leonardoAB1/mobile_robot_esp32/automation/lab_01/results/informe.pdf

# Implementation of a Low-Level Digital Controller for DC Motors

Laboratory 1

Leonardo Acha Boiano ´
Mechatronics Engineering: IMT 342 Universidad Catolica Boliviana ´ Santa Cruz de la Sierra, Bolivia leonardo.acha@ucb.edu.bo

Abstract

This report presents the implementation of a low-level digital controller for DC motors in the context of a mechatronics engineering laboratory. The work addresses from the measurement of the input signal to the implementation and evaluation of the digital controller. The process of measuring the input signal, monitoring pulse-width modulation (PWM), and implementing open-loop control of the DC motor is described. In the second part of the laboratory, an open-loop system for the plant is developed, a PID controller in parallel configuration is designed and tuned, and the parameters are transferred to the real plant. The experimental results show the performance of the closed-loop system against different types of inputs, such as sinusoidal signals and steps. This work provides a comprehensive overview of the implementation of digital controllers for DC motors in mechatronic applications.

Index Terms

Control, Motor, ESP32, PID, Matlab, Open Loop, Closed Loop, Encoder.

I. INTRODUCTION
This report presents the implementation of a low-level digital controller for DC motors in the context of a mechatronics engineering laboratory. This work focused on understanding and applying key concepts of control, pulse-width modulation (PWM), and closed-loop systems to optimize the performance and accuracy of the DC motor. Throughout the report, the stages of the experimental process are described, from the measurement of the input signal to the implementation and evaluation of the digital controller, providing a detailed view of this important area of mechatronics engineering.

II. PROCEDURE
The methodology used in the laboratory was developed as follows. First, the input signal was measured via the wifi connection implemented in the microcontroller, in this case, the STM32. The input signal was sinusoidal and came from a program simulating an analog signal generator, sending the digitized signal with a 16-bit resolution.
Subsequently, the correct operation of the pulse-width modulation (PWM) module was monitored using an oscilloscope to ensure that the PWM generated the signal correctly with varied frequencies.
Then, the pulse control of the DC motor was implemented, which involved calculating the PWM duty cycle based on the input signal as shown in Figure 1. Additionally, the direction of motor rotation was determined in relation to the ADC range, and the sign of the signal was provided separately.
The next step involved controlling the speed and direction of the motor, which was achieved by adjusting the PWM duty cycle.
To obtain the open-loop system’s Bode Plot of phase and amplitude, the system’s response to a step input was recorded, from which the system parameters were extracted.
In the second part of the laboratory, focused on building the closed-loop system, a digital controller was synthesized and implemented on the platform using the model previously obtained in the open-loop system to tune the controller in simulation. This controller was designed to meet technical specifications, including an overshoot of less than 30% and a system error of e = 2° for a signal at 0.05 Hz.
Finally, the quality of the closed-loop system was evaluated to ensure it met the established technical requirements.

III. RESULTS

A. Plant Development


Figure 1. Encoder Signal of the Motor Visualized on the Oscilloscope

Figure 1 shows the encoder signal of the DC motor, captured and visualized on an oscilloscope. This graphical representation is crucial for understanding how the motor’s position is translated into an electrical signal. The waveform displayed on the oscilloscope provides information about the speed and direction of the motor, which is essential for the control and monitoring of the system. It was experimentally calculated that the encoder of the motor used generated an average of 480 pulses per revolution. This number was approximated to 512 to be a power of 2, as is often the case with binary encoders.


Figure 2. Open-loop System Response to a Step Input

Figure 2 shows the open-loop system’s response to a step input. This graph is essential to understand the intrinsic behavior of the plant without any applied controller. It reveals aspects such as response time, overshoot, and the system’s inherent stability. Note that the initially measured signal exhibited a significant amount of noise. To mitigate this noise, a digital weighted moving average filter was implemented.

B. System Identification


Figure 3. System Identification

Figure 3 presents the system identification process. Using Matlab’s system identification, the plant parameters were identified and the same was discretized using the zero-order hold method. Through this procedure, the characteristic parameters of the plant are obtained, including its frequency response and dynamics.

0.04234z

−1
1 − 0.983z⁻¹

(1)

C. Controller Implementation
Once the system was identified, we proceeded to select a controller. In this case, we opted for the PID controller in parallel configuration due to its ease of being tuned using practical methods without requiring complex calculations. As shown in the following equations, the Tustin approximation was used to discretize this controller. Then, the controller parameters were fine-tuned through simulation. Finally, the parameters were transferred to the plant, correcting the inherent discrepancies between the simulated model and the real plant to minimize errors.

C(s) = Kp +

Ki
s
+ Kds | (2)

s = 2Ts ·

z − 1 z + 1 | (3)

C(s) = U(s) E(s)
= Kp +

Ki

2 Ts · z−1 z+1 + Kd ·

2 Ts · z−1 z+1 | (4)

C(s) = 2(z − 1)(z + 1)KpTs + KiT²
s
(z + 1)² + 4Kd(z − 1)² 2(z − 1)(z + 1)Ts | (5)
a = 2KpTs | (6)
b = KiT² s | (7)
c = 4Kd | (8)
d = 2Ts | (9)
U(z) E(z)
=

2(z − 1)(z + 1)KpTs + KiT²
s
(z + 1)² + 4Kd(z − 1)² 2(z − 1)(z + 1)Ts | (10)

U(z)
E(z)

=

a(z − 1)(z + 1) + b(z + 1)² + c(z − 1)
2d(z − 1)(z + 1) | (11)

U(z)
E(z)

=

az² − a + bz² + 2bz + b + cz² − 2cz + c d(z

2 − 1) | (12)

U(z)
E(z)

=

(a + b + c)z

2 + 2(b − c)z + (b + c − a)
d(z
2 − 1) | (13)

U(z) E(z)
=

(a + b + c) + 2(b − c)z

−1 + (b + c − a)z

−2 d(1 − z⁻²) | (14)

u(k) = (a + b + c)
d

e(k) + 2(b − c)
d

e(k − 1) + (b + c − a)
d
e(k − 2) + u(k − 2) | (15)

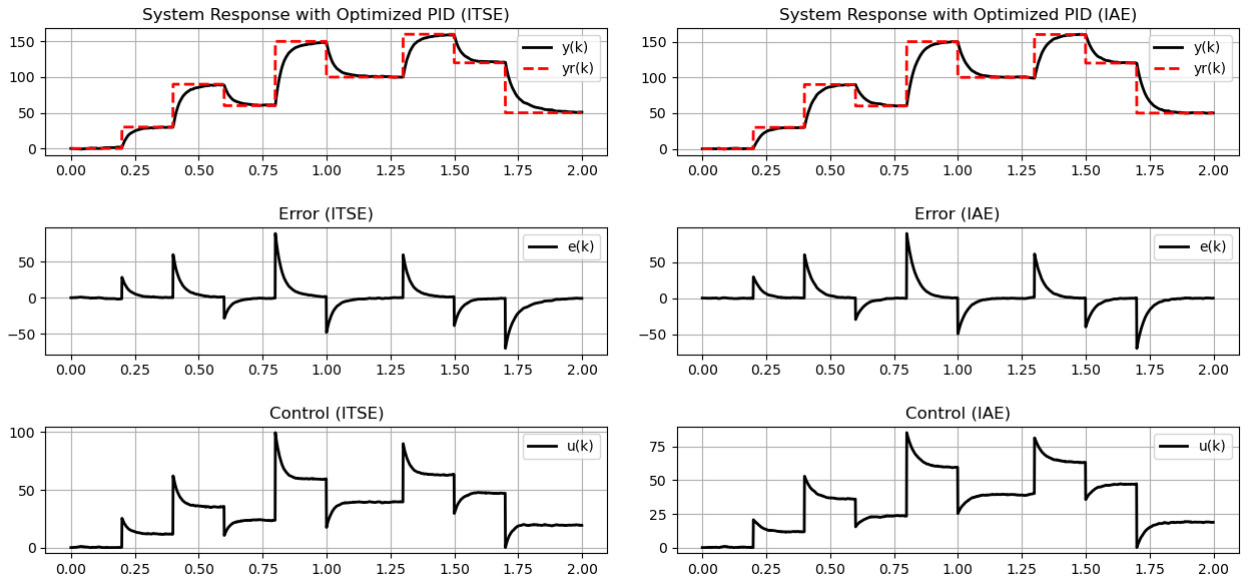
[picture p10: figure]

Figure 4. Closed-loop System Simulation to a Step Input

Figure 4 illustrates the closed-loop system simulation in response to a step input. This simulation is crucial to evaluate and refine the behavior of the controlled system before implementing it on the physical plant. It provides an anticipated view of how the real system will respond under control.

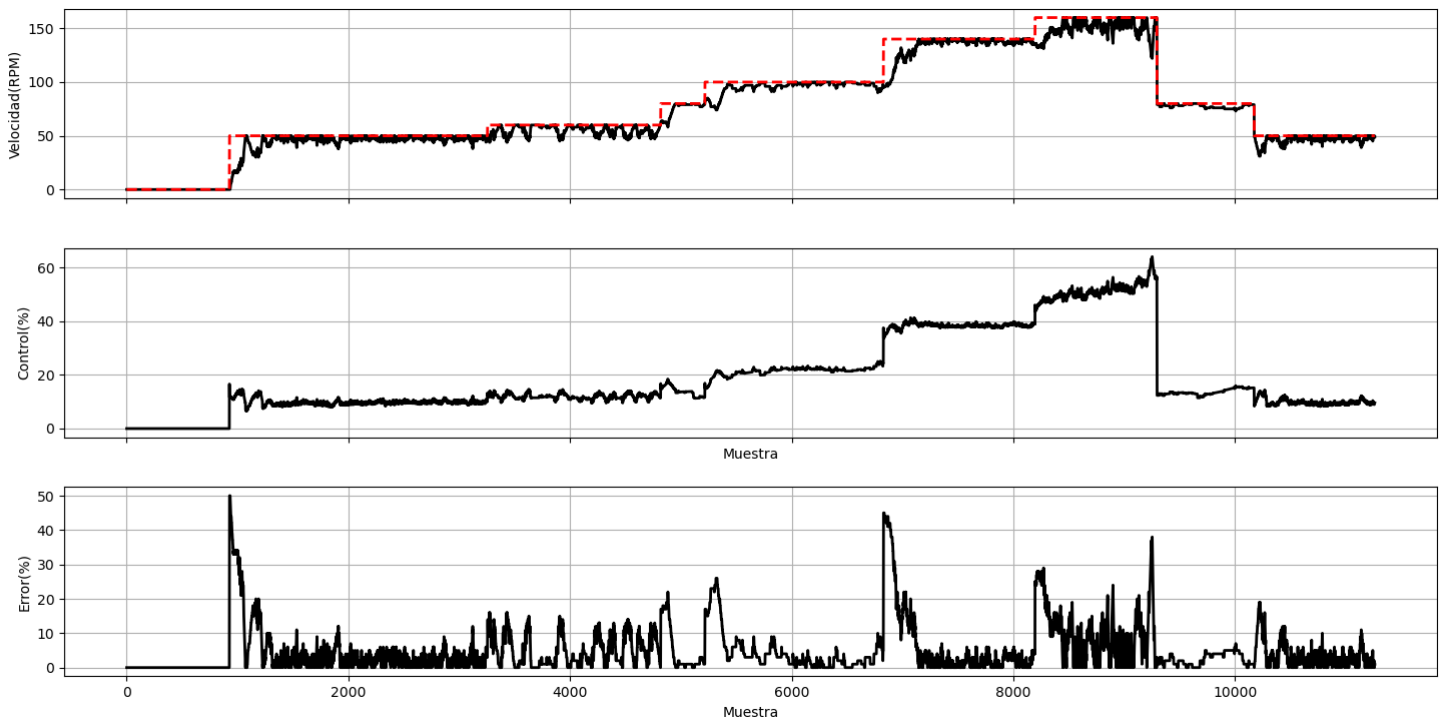
[picture p11: figure]

Figure 5. Controller Parameter Calibration with the Plant in Operation

Figure 5 describes the process of calibrating the controller parameters while the plant is in operation. This critical step ensures that the controller is optimally adjusted to the specific characteristics and dynamics of the real plant.


Figure 6. Closed-loop System Response to a Sinusoidal Input with a Frequency of 0.05 Hz

The analysis of the experimentally collected data shows that the phase lag of the developed system concerning a sinusoidal signal of 0.05 Hz is 1.24°, as observed in Figure 6.

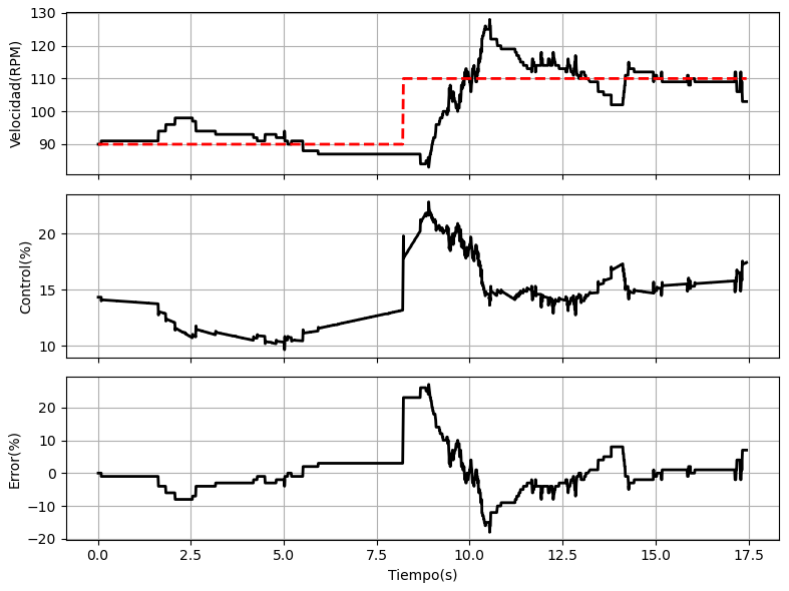
[picture p12: figure]

Figure 7. Closed-loop System Response to a Step Input

Finally, the analysis of the step response for a change of 20 RPM shows an overshoot of 16.36%, as seen in Figure 7.

IV. CONCLUSION
This report presented the implementation of a low-level digital controller for DC motors in the context of a mechatronics engineering laboratory. Several key stages have been addressed throughout the work, from the measurement of the input signal to the implementation and evaluation of the digital controller.
The experimental process began with the measurement of the input signal, which was a sinusoidal signal generated by an analog signal generator simulator program. Then, the pulse-width modulation (PWM) module’s operation was monitored to ensure its correct functioning. Subsequently, the DC motor’s pulse control was implemented, calculating the PWM duty cycle based on the input signal and the motor’s rotation direction.
In the second part of the laboratory, an open-loop system for the plant was developed, obtaining its frequency response and dynamics. Then, a PID controller in parallel configuration was designed and tuned through simulation using the plant model. These parameters were transferred to the real plant after correcting the discrepancies between the model and the real plant. The experimental results showed the closed-loop system’s response to different types of inputs, such as sinusoidal signals and steps. A system phase lag of 1.24° and an overshoot of 16.36% in the step response were observed, indicating that the digital controller achieves good performance in terms of reference tracking and stability.
In summary, this work provides a detailed view of the implementation of a low-level digital controller for DC motors in a mechatronics engineering laboratory environment. It has demonstrated the importance of system identification, controller tuning, and correcting discrepancies between the model and the real plant to achieve satisfactory control system performance.
