leonardoAB1/mobile_robot_esp32/documentation/CAD/base_robot_movil.jpg

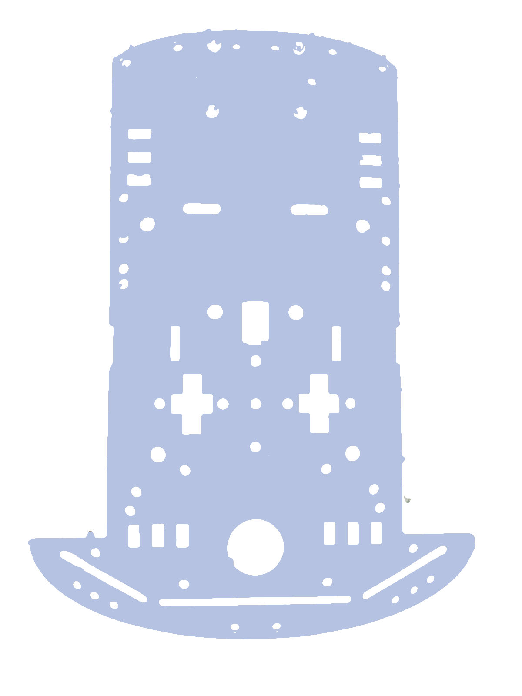
documentation/CAD/base_robot_movil.jpg
