leonardoAB1/mobile_robot_esp32/documentation/electronics/AR2770-GM-25-370-Encoder-12V-DC-140RPM-V10.png

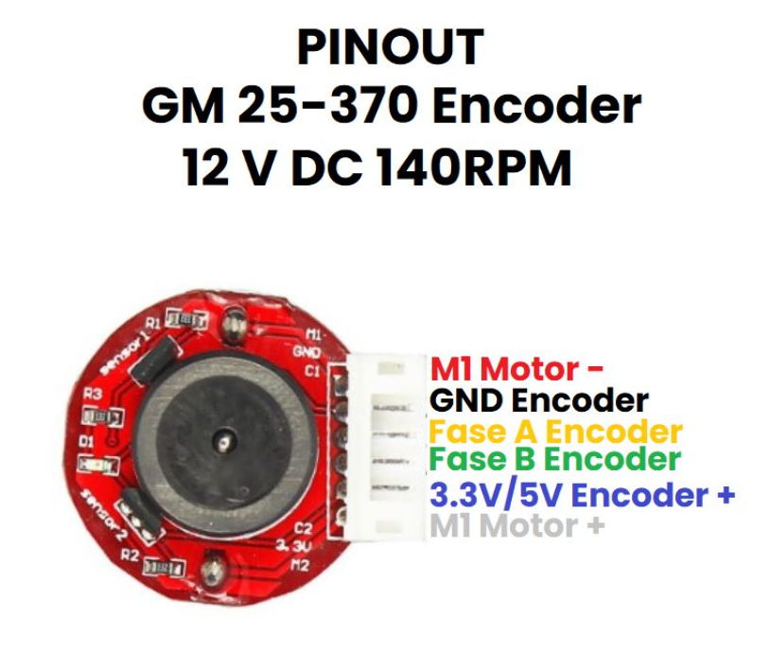
documentation/electronics/AR2770-GM-25-370-Encoder-12V-DC-140RPM-V10.png
