leonardoAB1/mobile_robot_esp32/documentation/electronics/pcb_prototype.png

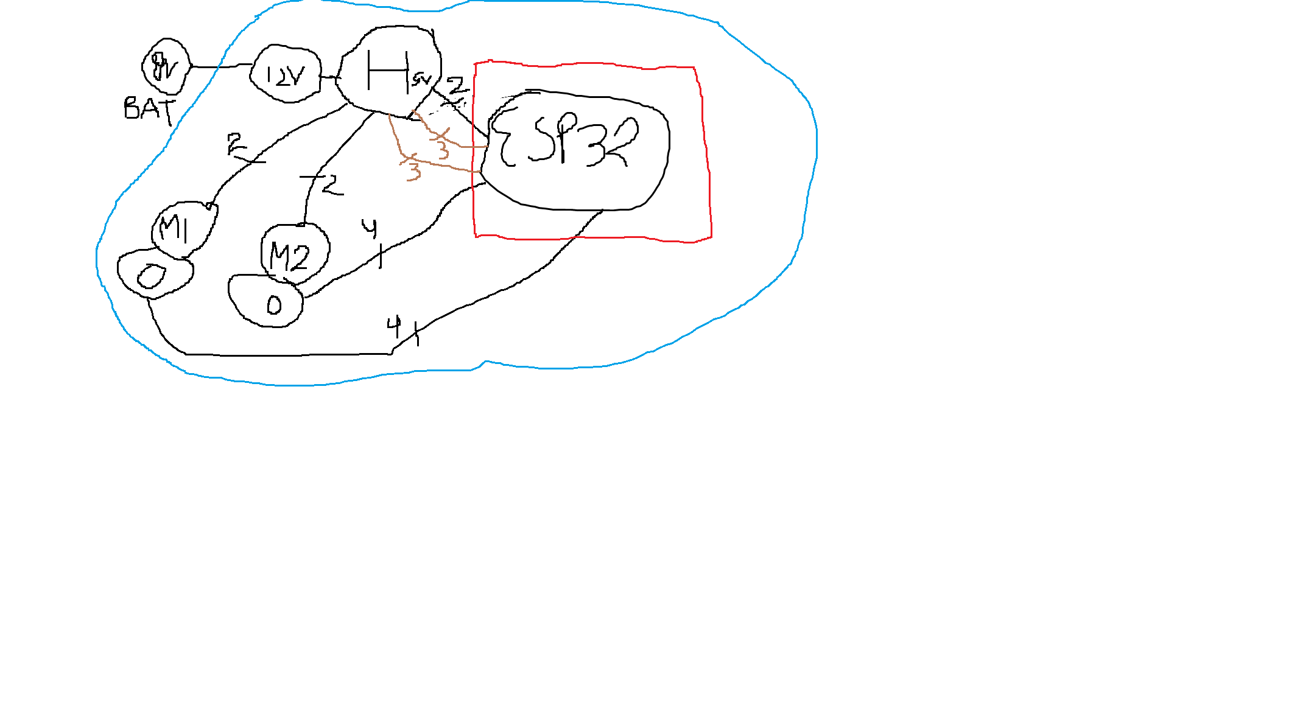
documentation/electronics/pcb_prototype.png
