leonardoAB1/mobile_robot_esp32/documentation/electronics/PUENTE_H.jpeg

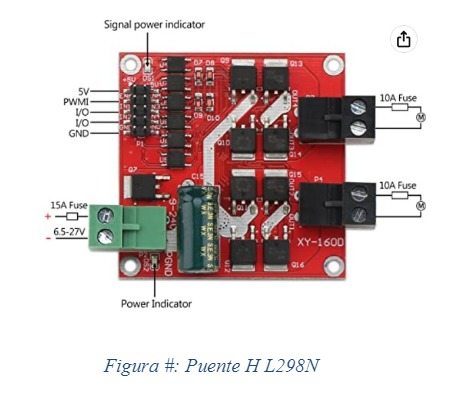
documentation/electronics/PUENTE_H.jpeg
