leonardoAB1/mobile_robot_esp32/documentation/CAD/rueda.SLDASM

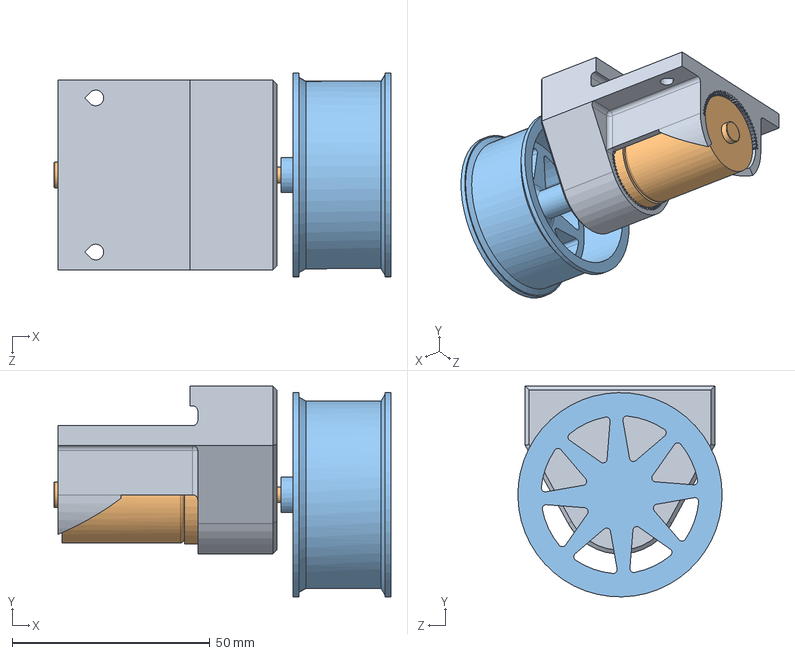
[picture p17: CAD file, 2023-10-09]
documentation/CAD/rueda.SLDASM
85.3 x 53.3 x 51.7 mm
mounting_motor
JGA25-370
llanta
