leonardoAB1/mobile_robot_esp32/documentation/CAD/robot_mobil.SLDASM

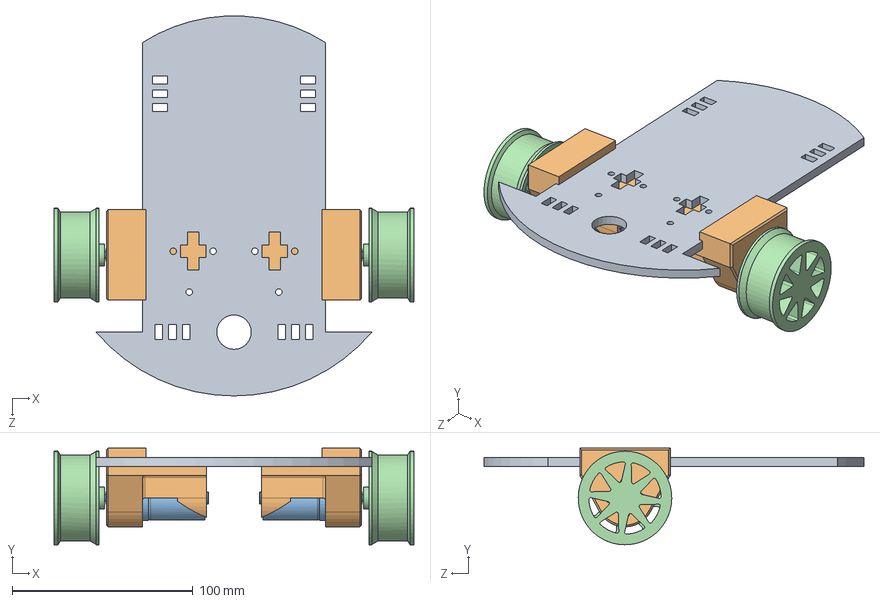
[picture p18: CAD file, 2023-10-09]
documentation/CAD/robot_mobil.SLDASM
198.9 x 53.3 x 209.9 mm
bse
mounting_motor x 2
JGA25-370 x 2
llanta x 2
