leonardoAB1/mobile_robot_esp32/documentation/CAD/3d_print/CCR10M_mounting_motor.3mf

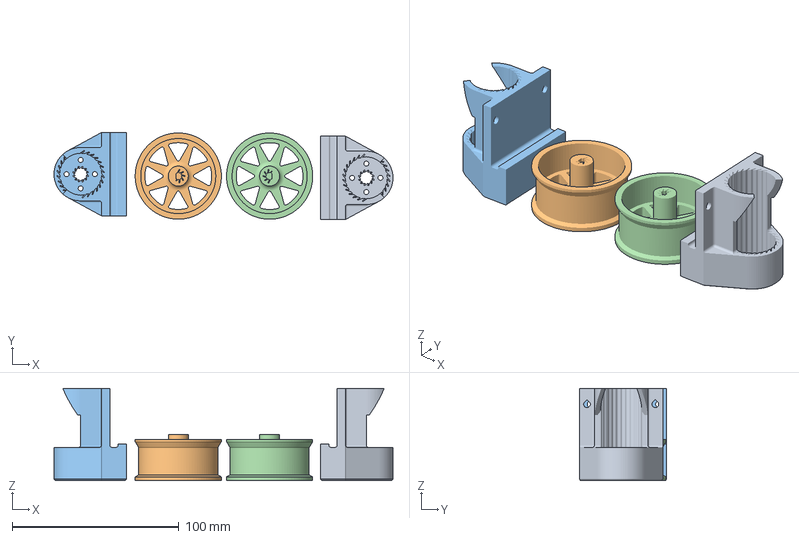
[picture p19: CAD file, 2023-10-09]
documentation/CAD/3d_print/CCR10M_mounting_motor.3mf
203.3 x 52.2 x 55.4 mm
mounting_motor.STL
llanta.STL
mounting_motor.STL(1)
llanta.STL(1)
