leonardoAB1/mobile_robot_esp32/documentation/CAD/llanta.SLDPRT

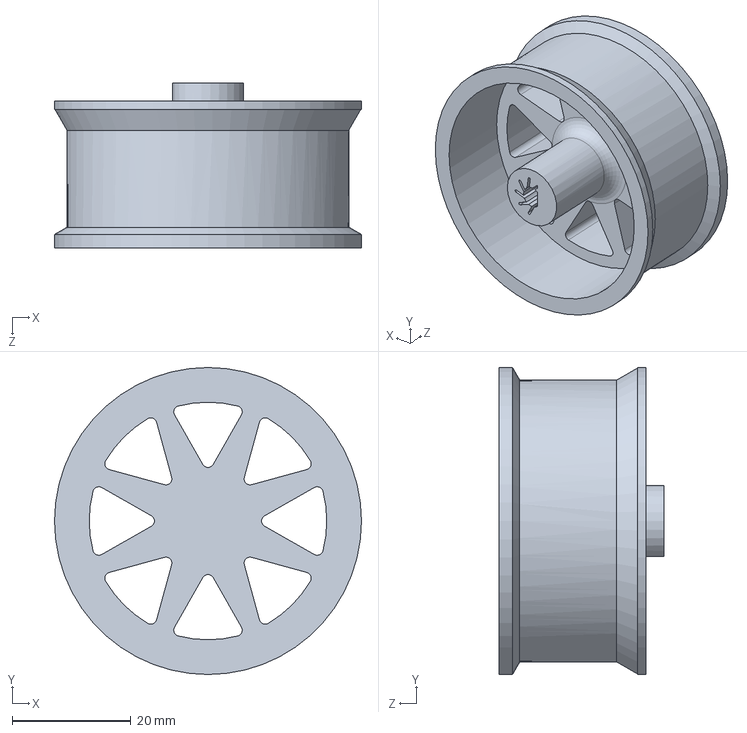
[picture p20: CAD file, 2023-10-09]
documentation/CAD/llanta.SLDPRT
51.7 x 51.7 x 27.8 mm
