leonardoAB1/mobile_robot_esp32/documentation/CAD/3d_print/CCR10M_robot_mobil.3mf

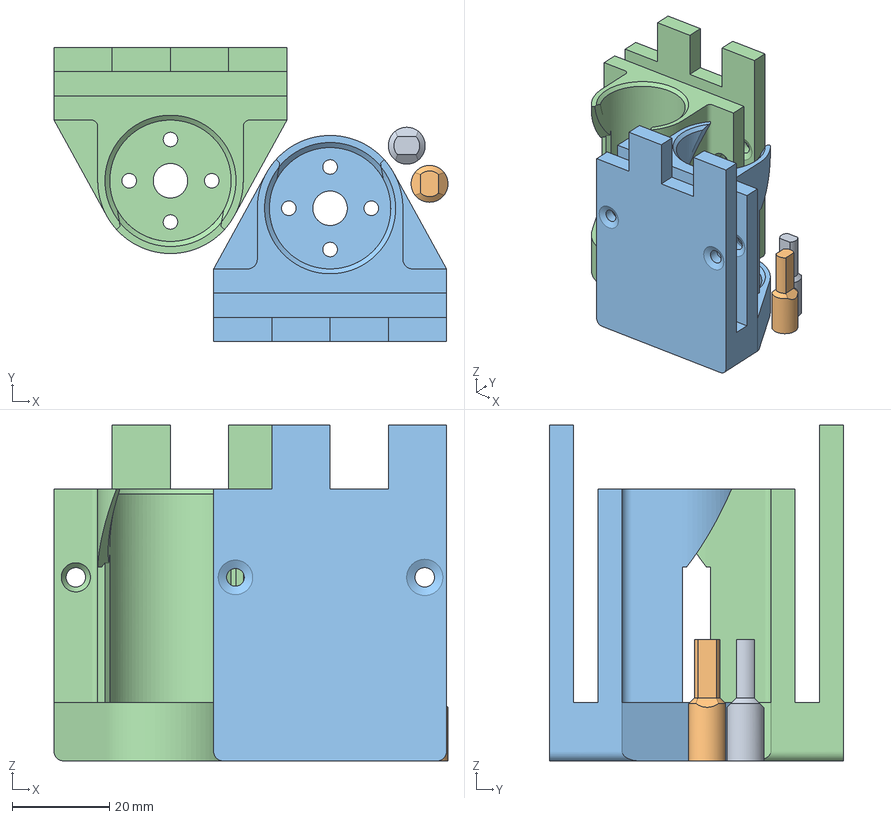
[picture p21: CAD file, 2023-10-09]
documentation/CAD/3d_print/CCR10M_robot_mobil.3mf
81.2 x 60.7 x 69.2 mm
acople_ruedas.STL
acople_ruedas.STL(1)
mounting_motor_derecha.STL
mounting_motor_izquierda.STL
