leonardoAB1/mobile_robot_esp32/documentation/CAD/3d_print/CCR10M_robot_mobil2.3mf

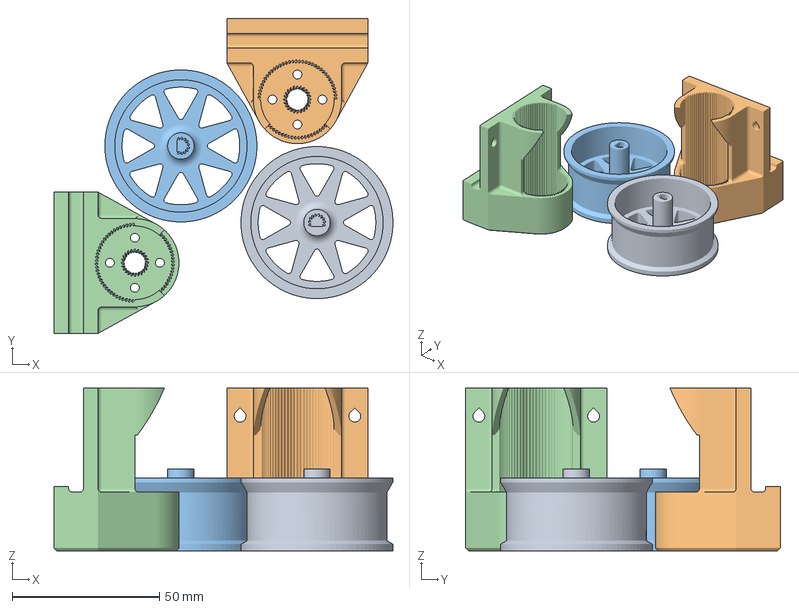
[picture p22: CAD file, 2023-10-09]
documentation/CAD/3d_print/CCR10M_robot_mobil2.3mf
115.3 x 107.0 x 55.4 mm
llanta.STL
mounting_motor.STL
llanta.STL(1)
mounting_motor.STL(1)
