leonardoAB1/mobile_robot_esp32/documentation/CAD/bse.SLDPRT

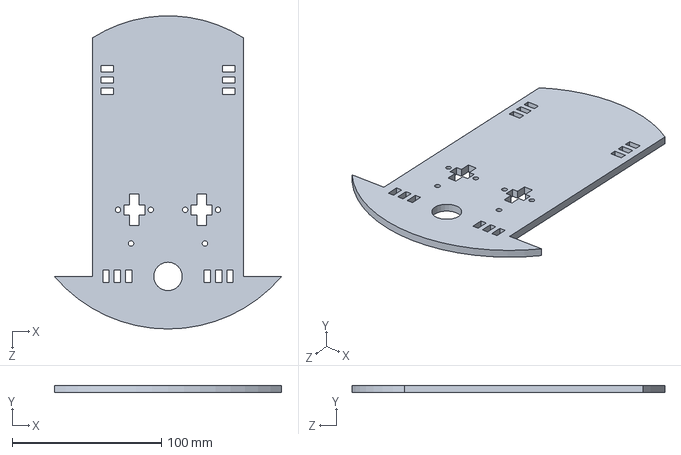
[picture p23: CAD file, 2023-10-09]
documentation/CAD/bse.SLDPRT
152.4 x 5.00 x 209.9 mm
