leonardoAB1/mobile_robot_esp32/documentation/CAD/mounting_motor.SLDPRT

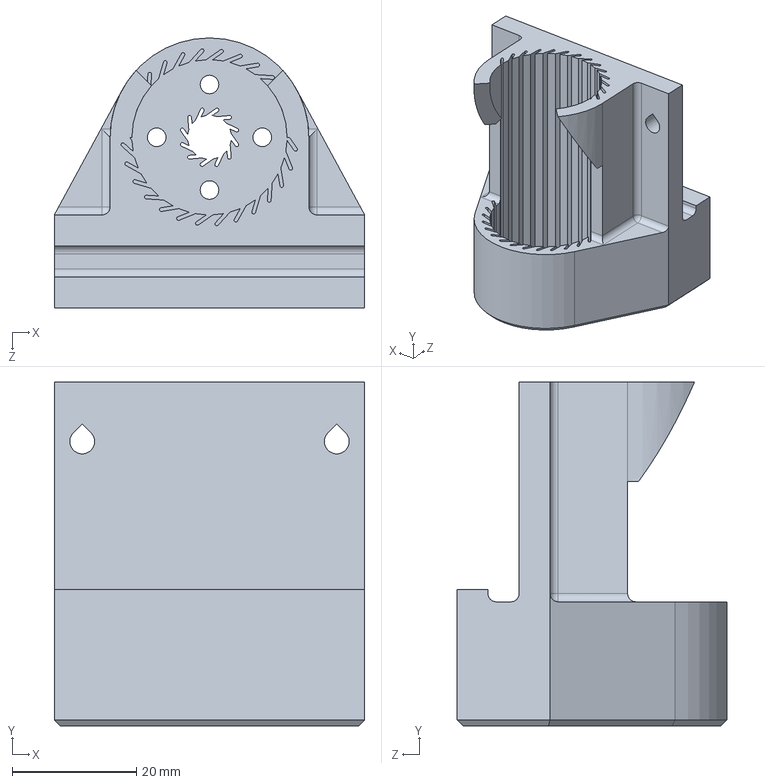
[picture p24: CAD file, 2023-10-09]
documentation/CAD/mounting_motor.SLDPRT
50.0 x 55.4 x 43.5 mm
