leonardoAB1/mobile_robot_esp32/documentation/CAD/JGA25-370.SLDPRT

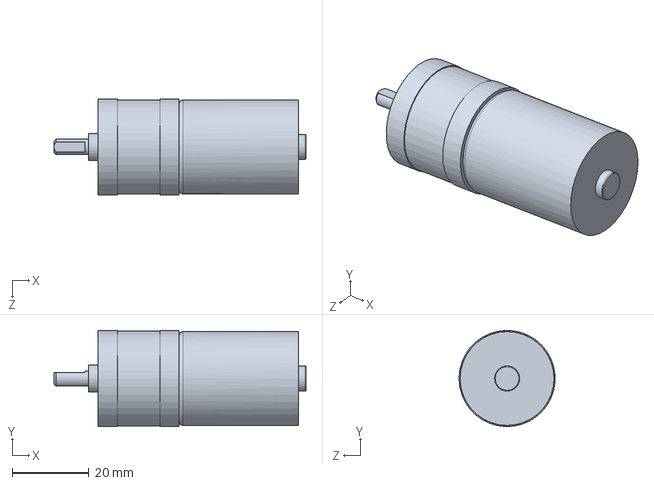
[picture p25: CAD file, 2023-10-09]
documentation/CAD/JGA25-370.SLDPRT
65.5 x 25.0 x 25.0 mm
