leonardoAB1/mobile_robot_esp32/(list of files, cad)

Other CAD files:
documentation/CAD/3d_print/CCR10M_robot_mobil3.3mf
documentation/CAD/3d_print/llanta.STL
documentation/CAD/3d_print/mounting_motor.STL
