leonardoAB1/mobile_robot_esp32/documentation/experiments/lab_02/M1_STEP_RESPONSE.png

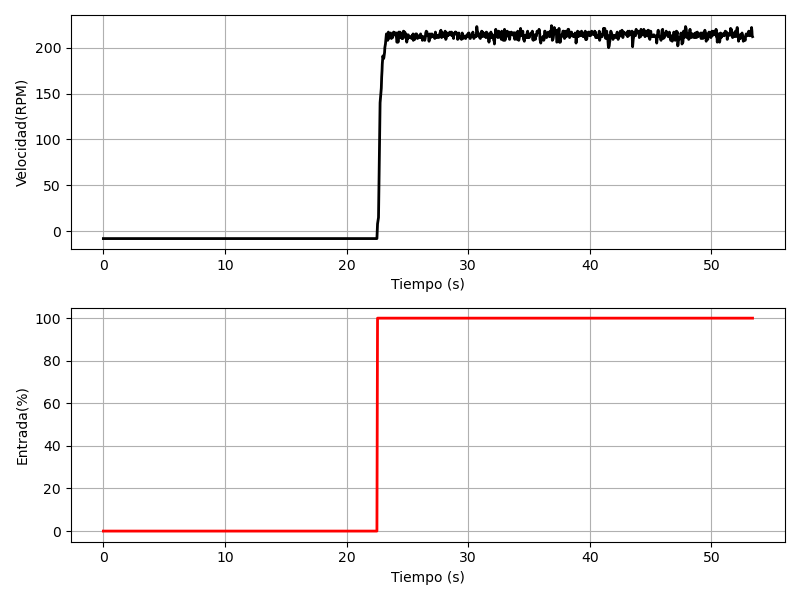
documentation/experiments/lab_02/M1_STEP_RESPONSE.png
