leonardoAB1/mobile_robot_esp32/documentation/experiments/lab_01/data_ppr.xlsx

i | T(s) | Vueltas | Velocidad angular (rev/s) | f (Pulsos/s) | PPR
1 | 13.00 | 5.00 | 0.38 | 250.00 | 650.00
2 | 27.00 | 10.00 | 0.37 | 178.57 | 482.14
3 | 9.00 | 3.00 | 0.33 | 178.57 | 535.71
4 | 19.00 | 7.00 | 0.37 | 178.57 | 484.69
5 | 24.00 | 9.00 | 0.38 | 178.57 | 476.19
6 | 28.00 | 10.00 | 0.36 | 178.57 | 500.00
7 | 21.00 | 9.00 | 0.43 | 178.57 | 416.67
8 | 29.00 | 12.00 | 0.41 | 178.57 | 431.55
9 | 14.00 | 5.00 | 0.36 | 178.57 | 500.00
10 | 14.00 | 4.00 | 0.29 | 90.00 | 315.00
11 | 20.00 | 7.00 | 0.35 | 178.57 | 510.20
12 | 8.00 | 8.00 | 1.00 | 430.00 | 430.00
12 | 9.00 | 10.00 | 1.11 | 460.00 | 414.00
 | 20.00 | 7.00 | 0.37 | 179.00 | 482.00
 |  |  |  |  | 512
 |  |  |  |  | 0.703125
