leonardoAB1/mobile_robot_esp32/documentation/experiments/lab_01/figures/Figure_1_ewma_filter_01.png

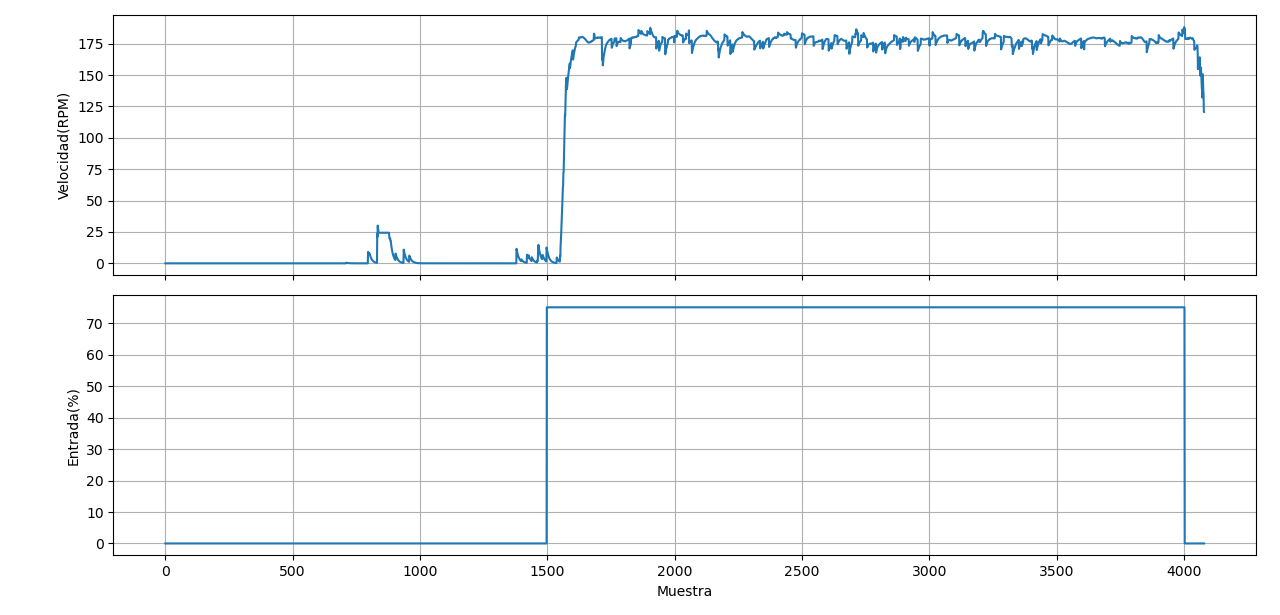
documentation/experiments/lab_01/figures/Figure_1_ewma_filter_01.png
