leonardoAB1/mobile_robot_esp32/documentation/experiments/lab_01/figures/Figure_3.jpg

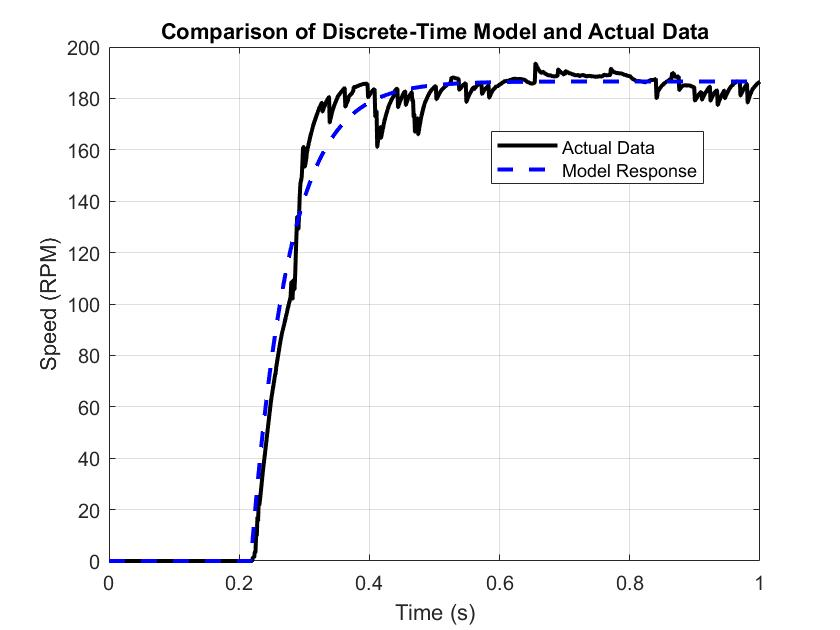
documentation/experiments/lab_01/figures/Figure_3.jpg
