leonardoAB1/mobile_robot_esp32/documentation/experiments/lab_01/figures/Figure_4png.png

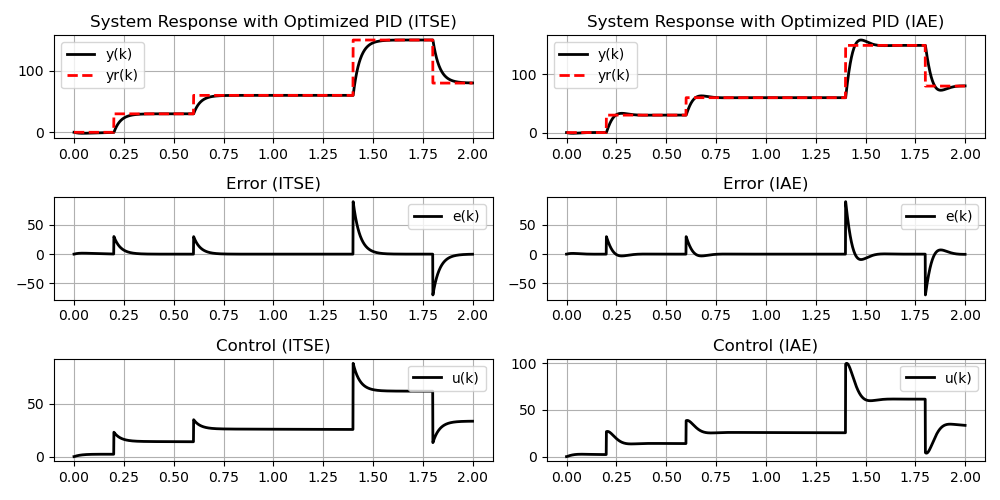
documentation/experiments/lab_01/figures/Figure_4png.png
