leonardoAB1/mobile_robot_esp32/documentation/experiments/lab_01/figures/Figure_5_PI.png

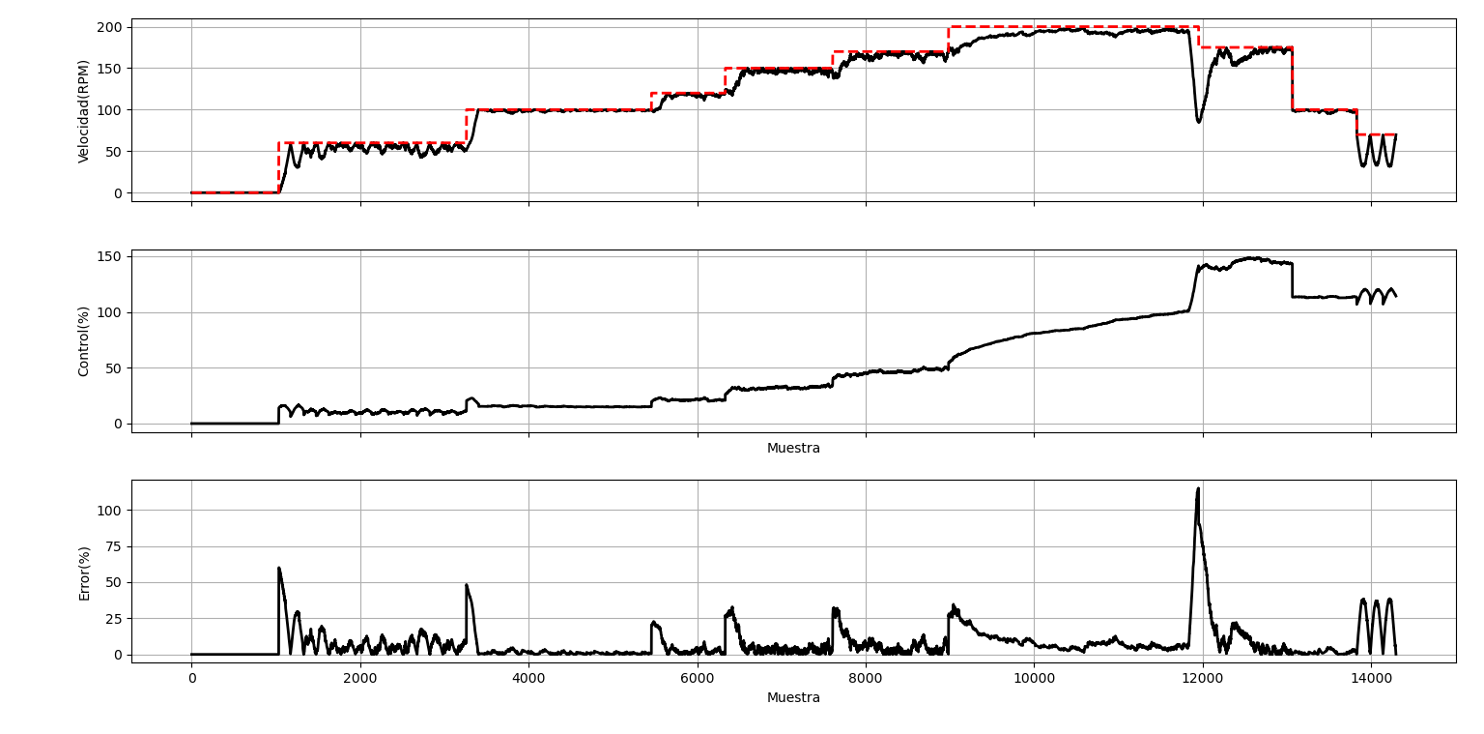
documentation/experiments/lab_01/figures/Figure_5_PI.png
