leonardoAB1/mobile_robot_esp32/documentation/experiments/lab_01/images/20230826_181359.jpg

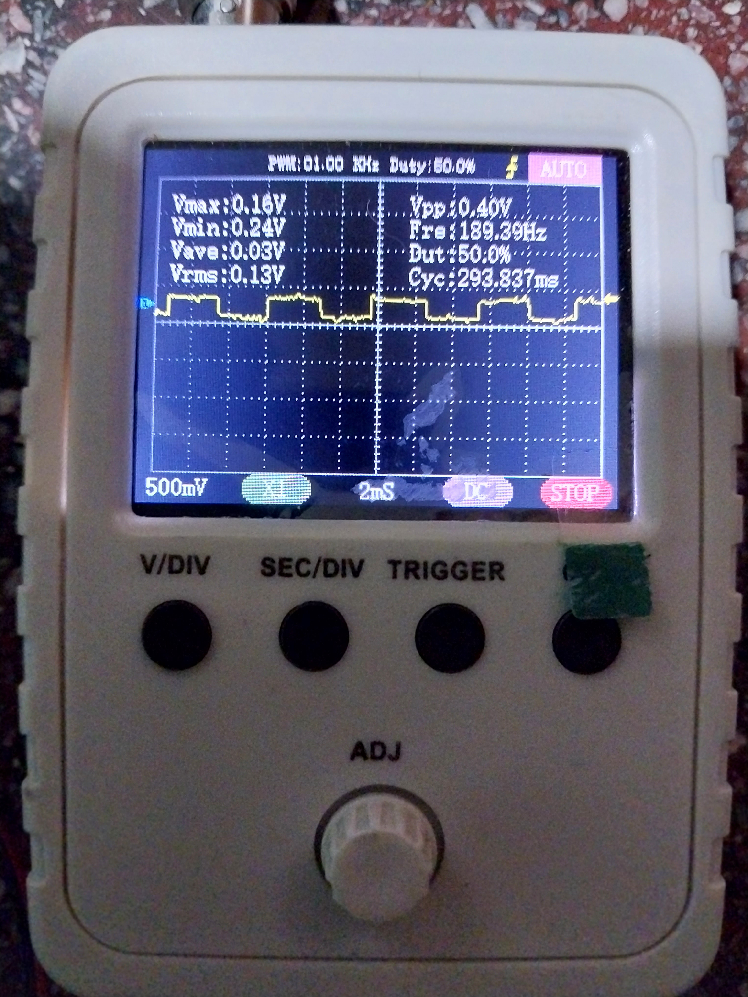
documentation/experiments/lab_01/images/20230826_181359.jpg
