leonardoAB1/mobile_robot_esp32/documentation/experiments/lab_02/IK_VS_FK.png

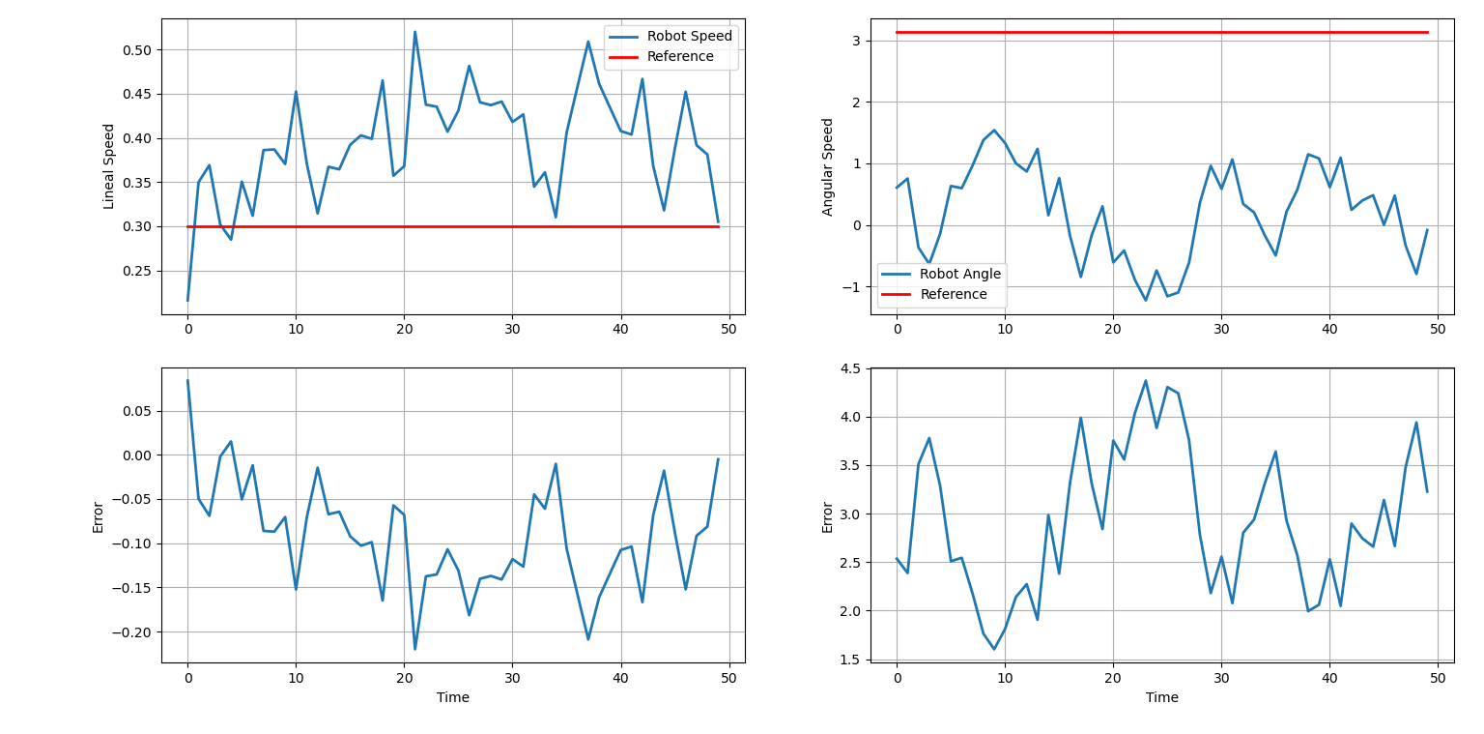
documentation/experiments/lab_02/IK_VS_FK.png
