leonardoAB1/mobile_robot_esp32/documentation/experiments/lab_02/M2_IDENTIFICACION_SISTEMA.png

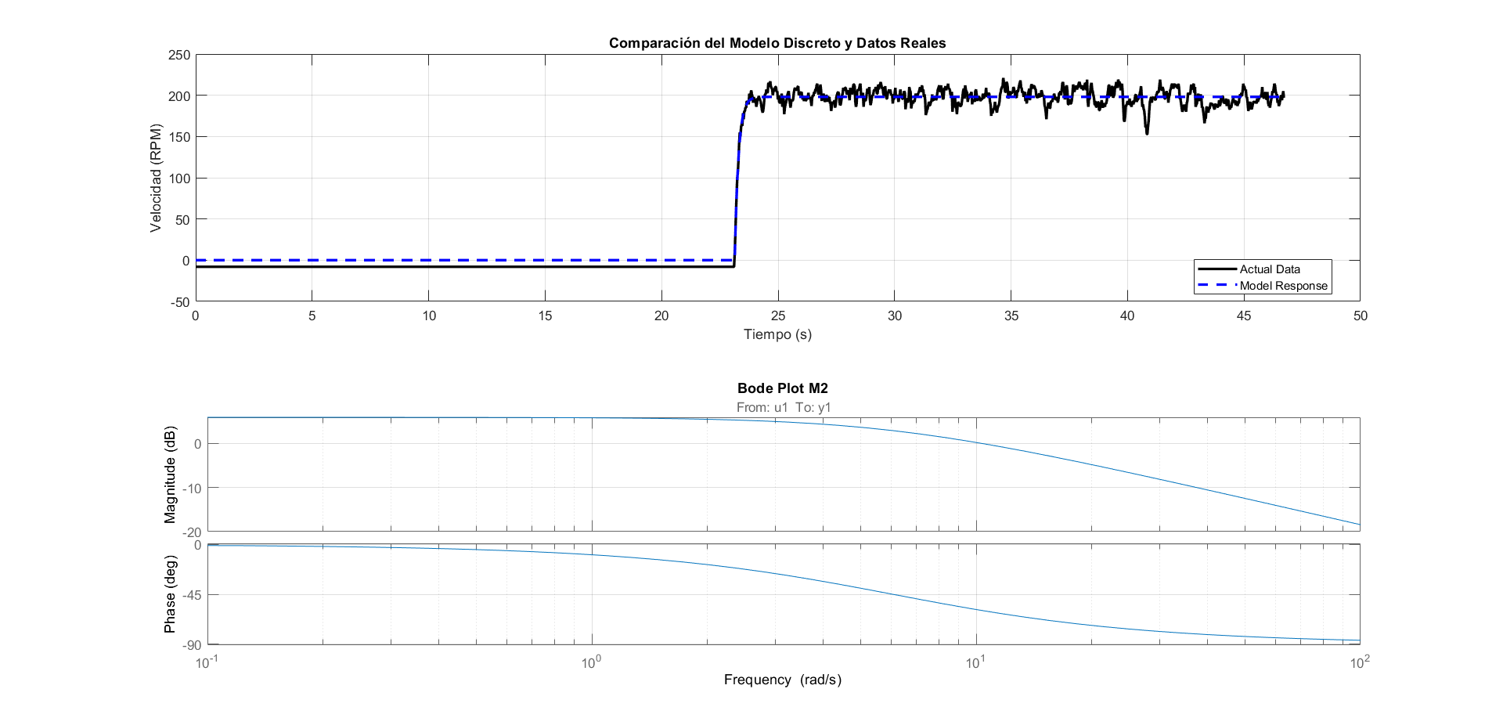
documentation/experiments/lab_02/M2_IDENTIFICACION_SISTEMA.png
