leonardoAB1/mobile_robot_esp32/documentation/experiments/lab_02/PARTICULARIDADES_DE_USAR_RTOS.png

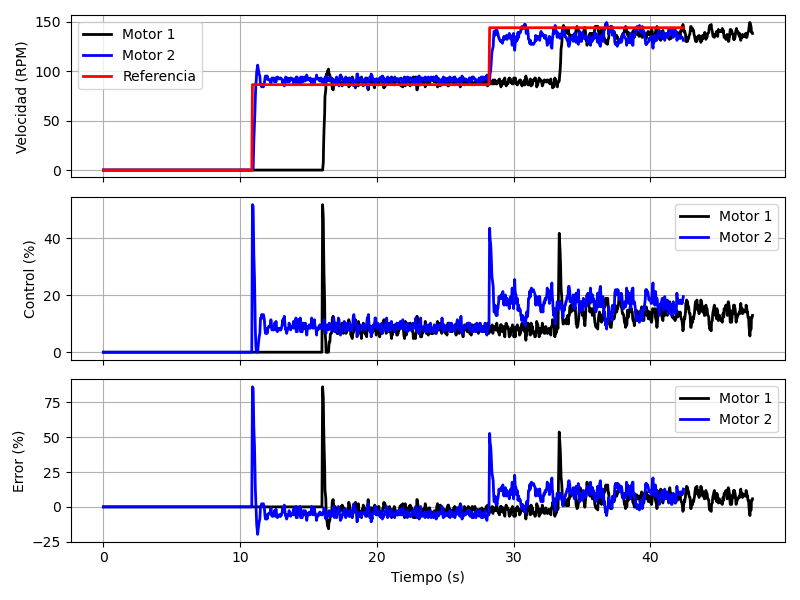
documentation/experiments/lab_02/PARTICULARIDADES_DE_USAR_RTOS.png
