leonardoAB1/mobile_robot_esp32/main/src/web_server/web_server.c

/*******************************************************************************
 * @file        web_server.c
 * @brief       Web Server Implementation
 * @details     This file contains the implementation of a web server for an ESP32-CAM development board.
 *              It provides functions to start the web server and register URI handlers.
 * @author      Leonardo Acha Boiano
 * @date        7 Jun 2023
 *
 * @note        This code is written in C and is used on an ESP32-CAM development board.
 *
 *******************************************************************************/

#include "../web_server/web_server.h"

// Function to start the web server
void start_webserver(void)
{
    httpd_handle_t server = NULL;
    httpd_config_t config = HTTPD_DEFAULT_CONFIG();
    config.core_id = 1;  // Set the core ID to 0 (core 0)
    config.max_uri_handlers = 20;
    config.task_priority    = tskIDLE_PRIORITY+3;
    //config.uri_match_fn     = httpd_uri_match_wildcard;

    // Start the HTTP server
    if (httpd_start(&server, &config) == ESP_OK)
    {
        // Set URI handlers
        httpd_uri_t status_uri = {
            .uri = "/status",
            .method = HTTP_GET,
            .handler = status_httpd_handler,
            .user_ctx = NULL
        };
        httpd_register_uri_handler(server, &status_uri);

        httpd_uri_t reference1_set_uri = {
            .uri = "/reference1/set",
            .method = HTTP_POST,
            .handler = handle_set_reference1, 
            .user_ctx = NULL
        };
        httpd_register_uri_handler(server, &reference1_set_uri);

        httpd_uri_t reference1_get_uri = {
            .uri = "/reference1/get",
            .method = HTTP_GET,
            .handler = handle_get_reference1, 
            .user_ctx = NULL
        };
        httpd_register_uri_handler(server, &reference1_get_uri);

        httpd_uri_t encoder1_get_uri = {
            .uri = "/encoder1/get",
            .method = HTTP_GET,
            .handler = handle_get_encoder1, 
            .user_ctx = NULL
        };
        httpd_register_uri_handler(server, &encoder1_get_uri);

        httpd_uri_t reference2_set_uri = {
            .uri = "/reference2/set",
            .method = HTTP_POST,
            .handler = handle_set_reference2, 
            .user_ctx = NULL
        };
        httpd_register_uri_handler(server, &reference2_set_uri);

        httpd_uri_t reference2_get_uri = {
            .uri = "/reference2/get",
            .method = HTTP_GET,
            .handler = handle_get_reference2, 
            .user_ctx = NULL
        };
        httpd_register_uri_handler(server, &reference2_get_uri);

        httpd_uri_t encoder2_get_uri = {
            .uri = "/encoder2/get",
            .method = HTTP_GET,
            .handler = handle_get_encoder2, 
            .user_ctx = NULL
        };
        httpd_register_uri_handler(server, &encoder2_get_uri);

        httpd_uri_t robot_speed_set_uri = {
            .uri = "/robot/speed/set",
            .method = HTTP_POST,
            .handler = handle_set_robot_speed, 
            .user_ctx = NULL
        };
        httpd_register_uri_handler(server, &robot_speed_set_uri);

        httpd_uri_t robot_speed_get_uri = {
            .uri = "/robot/speed/get",
            .method = HTTP_GET,
            .handler = handle_get_robot_speed, 
            .user_ctx = NULL
        };
        httpd_register_uri_handler(server, &robot_speed_get_uri);

        httpd_uri_t robot_distance_reset_uri = {
            .uri = "/robot/distance/reset",
            .method = HTTP_POST,
            .handler = handle_reset_robot_distance, 
            .user_ctx = NULL
        };
        httpd_register_uri_handler(server, &robot_distance_reset_uri);

        httpd_uri_t robot_distance_get_uri = {
            .uri = "/robot/distance/get",
            .method = HTTP_GET,
            .handler = handle_get_robot_distance, 
            .user_ctx = NULL
        };
        httpd_register_uri_handler(server, &robot_distance_get_uri);

        ESP_LOGI(WEBSERVER_TAG, "HTTP server started");
    }
}

/********************************* END OF FILE ********************************/
/******************************************************************************/
