leonardoAB1/mobile_robot_esp32/(commit log)

2023-09-04 files to update pwm rate, reference signal and so on
2023-09-04 added ref docs and experiments data
    [data_ppr.xlsx]
2023-09-25 PID controller implemented por 1 motor according to requierements
2023-09-25 automation scripts for simulation, calcualtions and tests added
    [extracted_data.csv]
2023-10-09 cad model and pcb prototype added
    [CCR10M_mounting_motor.3mf, CCR10M_robot_mobil.3mf, CCR10M_robot_mobil2.3mf, CCR10M_robot_mobil3.3mf, JGA25-370.SLDPRT, Wheel D65x25.SLDPRT, acople_ruedas.SLDPRT, bse.SLDPRT]
2023-10-09 system scaled to 2 wheels
2023-10-09 unnecesary cad files removed
    [CCR10M_mounting_motor.3mf, CCR10M_robot_mobil.3mf, CCR10M_robot_mobil2.3mf, CCR10M_robot_mobil3.3mf, Wheel D65x25.SLDPRT, acople_ruedas.SLDPRT, llanta.STL, mounting_motor.STL]
2023-10-09 automation files organized by lab number
    [extracted_data.csv]
2023-10-09 direct and inveres kinematics implemented
2023-10-09 odometry implemented
2023-10-11 experiment pictures and diagrams of experiments added
    [data_ppr.xlsx]
2023-10-11 complementary scripts to test and records behavior of mobile robot
    [20231010162800_motor1.csv, 20231010162800_motor2.csv]
2023-10-11 lab 2 kinematics evaluated thru several test runs
    [20231011073548_robot_kinematics.csv, 20231011074955_robot_kinematics.csv, 20231011075210_robot_kinematics.csv, 20231011075527_robot_kinematics.csv, 20231011075900_robot_kinematics.csv, 20231011080053_robot_kinematics.csv, 20231011080250_robot_kinematics.csv, 20231011080403_robot_kinematics.csv]
2023-10-11 handler to test odometry calculations implemented
2023-10-14 lab 03 experiments
    [robot_positions.csv]
2023-10-15 Analisis de datos obtenidos en experimentos de odometria
